DanielHeEGG/Nixie-Controller/README.md

# Nixie-Controller
Yet another nixie clock controller.

See [Hackaday Page](https://hackaday.io/project/180811-open-nixie-controller) for more details.

This project is archived, development is continuing in [v2](https://github.com/DanielHeEGG/Nixie-Controller-v2).
