DanielHeEGG/Nixie-Controller/Design/PowerSupply/PowerSupply.kicad_pcb

## KiCad design Design/PowerSupply/PowerSupply.kicad_pcb (2020-09-08)

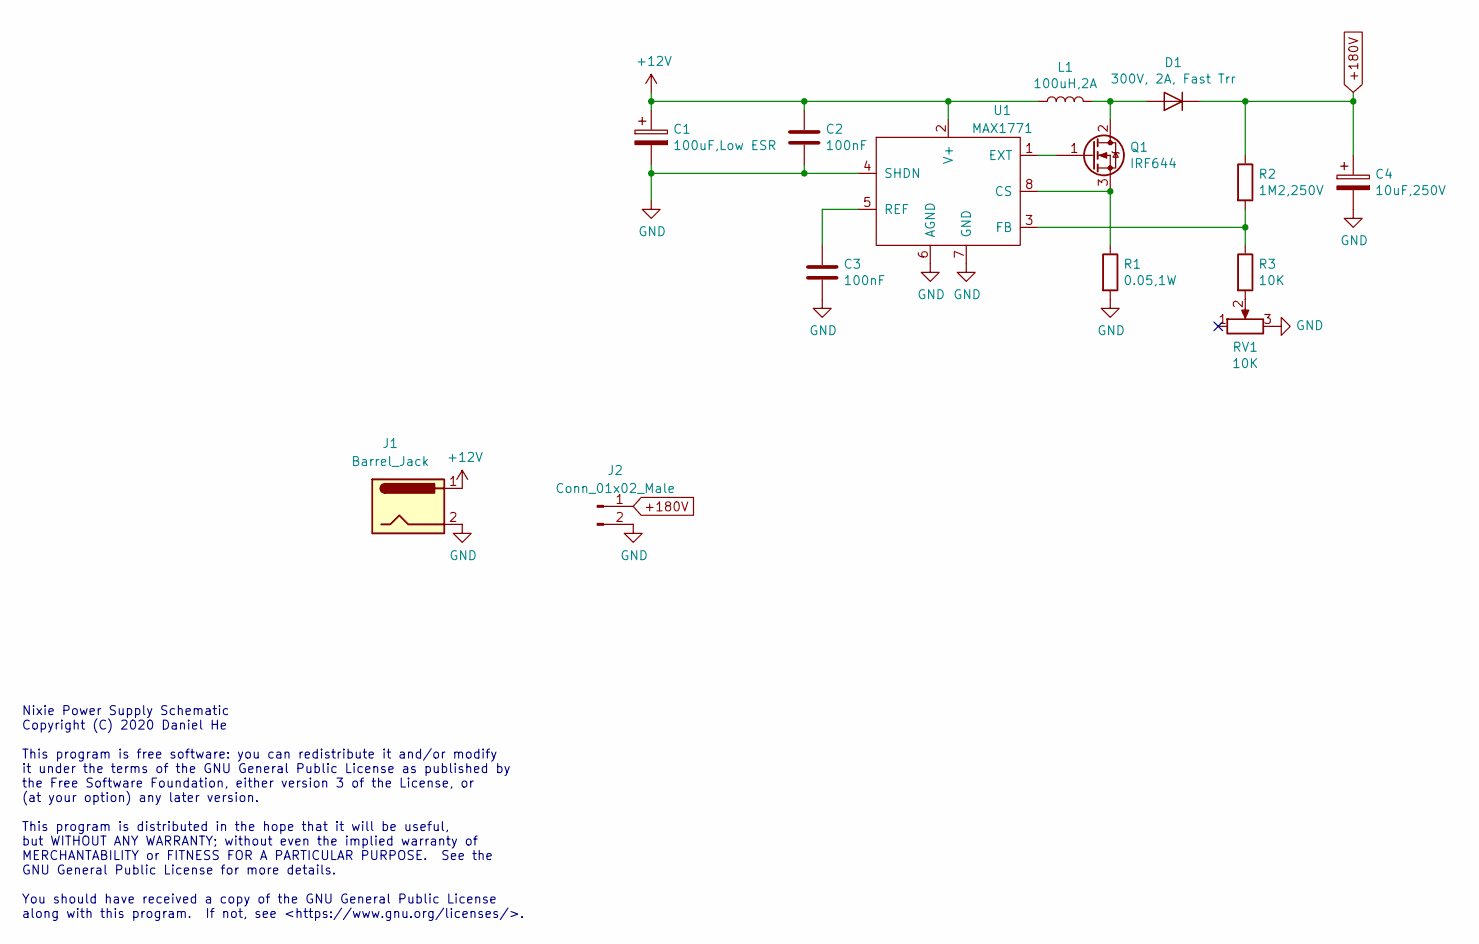
[picture p1: schematic PowerSupply.sch]

Parts:
C1: 100uF,Low ESR; CP_EIA-7343-31_Kemet-D; Digikey # 478-TPSD107M020R0150DKR-ND
C2, C3: 100nF; C_0805_2012Metric; Digikey # 1276-1007-6-ND
C4: 10uF,250V; CP_Elec_10x10; Digikey # PCE3432DKR-ND
D1: 300V, 2A, Fast Trr; D_SMB; Digikey # ES2F-E3/52TGIDKR-ND
J1: Barrel_Jack; BarrelJack_Horizontal; Digikey # 2092-KLDX-0202-A-ND
J2: Conn_01x02_Male; PinHeader_1x02_P2.54mm_Vertical
L1: 100uH,2A; L_12x12mm_H4.5mm; Digikey # 513-1526-6-ND
Q1: IRF644; TO-263-2; Digikey # IRF644STRLPBFDKR-ND
R1: 0.05,1W; R_2512_6332Metric; Digikey # YAG2156DKR-ND
R2: 1M2,250V; R_1206_3216Metric; Digikey # 311-1.2MERDKR-ND
R3: 10K; R_0805_2012Metric; Digikey # 311-10KARDKR-ND
RV1: 10K; Potentiometer_Bourns_3339P_Vertical; Digikey # 3362P-502LF-ND
U1: MAX1771; SOIC-8_3.9x4.9mm_P1.27mm; Digikey # MAX1771CSA+DKR-ND

Connections:
+12V: C1.1, C2.1, J1.1, L1.1, U1.2 (V+)
+180V: C4.1, D1.1 (K), J2.1, R2.1
GND: C1.2, C2.2, C3.2, C4.2, J1.2, J2.2, R1.2, RV1.3, U1.4 (SHDN), U1.6 (AGND), U1.7 (GND)
unnamed: C3.1, U1.5 (REF)
unnamed: D1.2 (A), L1.2, Q1.2 (D)
unnamed: Q1.1 (G), U1.1 (EXT)
unnamed: Q1.3 (S), R1.1, U1.8 (CS)
unnamed: R2.2, R3.1, U1.3 (FB)
unnamed: R3.2, RV1.2

Notes on the sheet:
Nixie Power Supply Schematic Copyright (C) 2020 Daniel He This program is free software: you can redistribute it and/or modify it under the terms of the GNU General Public License as published by the Free Software Foundation, either version 3 of the License, or (at your option) any later version. T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

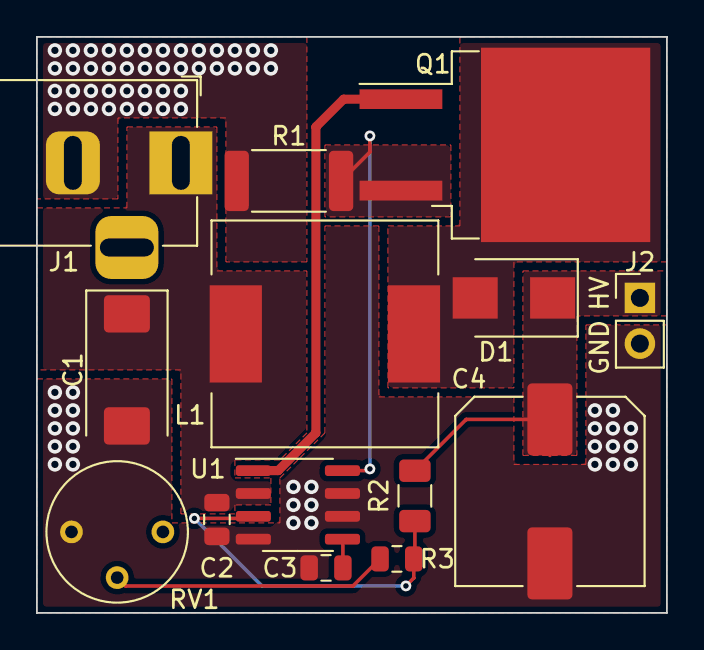
[picture p2: board PowerSupply.kicad_pcb from above]

Board: 2 copper layers, 35.0 x 32.0 mm, 15 parts (1 on the bottom side), 9 nets.

Other parts of the board:
CAUTION: Symbol_HighVoltage_Type2_CopperTop_VerySmall
