DanielHeEGG/Nixie-Controller/Design/Controller/NixieController.kicad_pcb

## KiCad design Design/Controller/NixieController.kicad_pcb (2020-09-08)

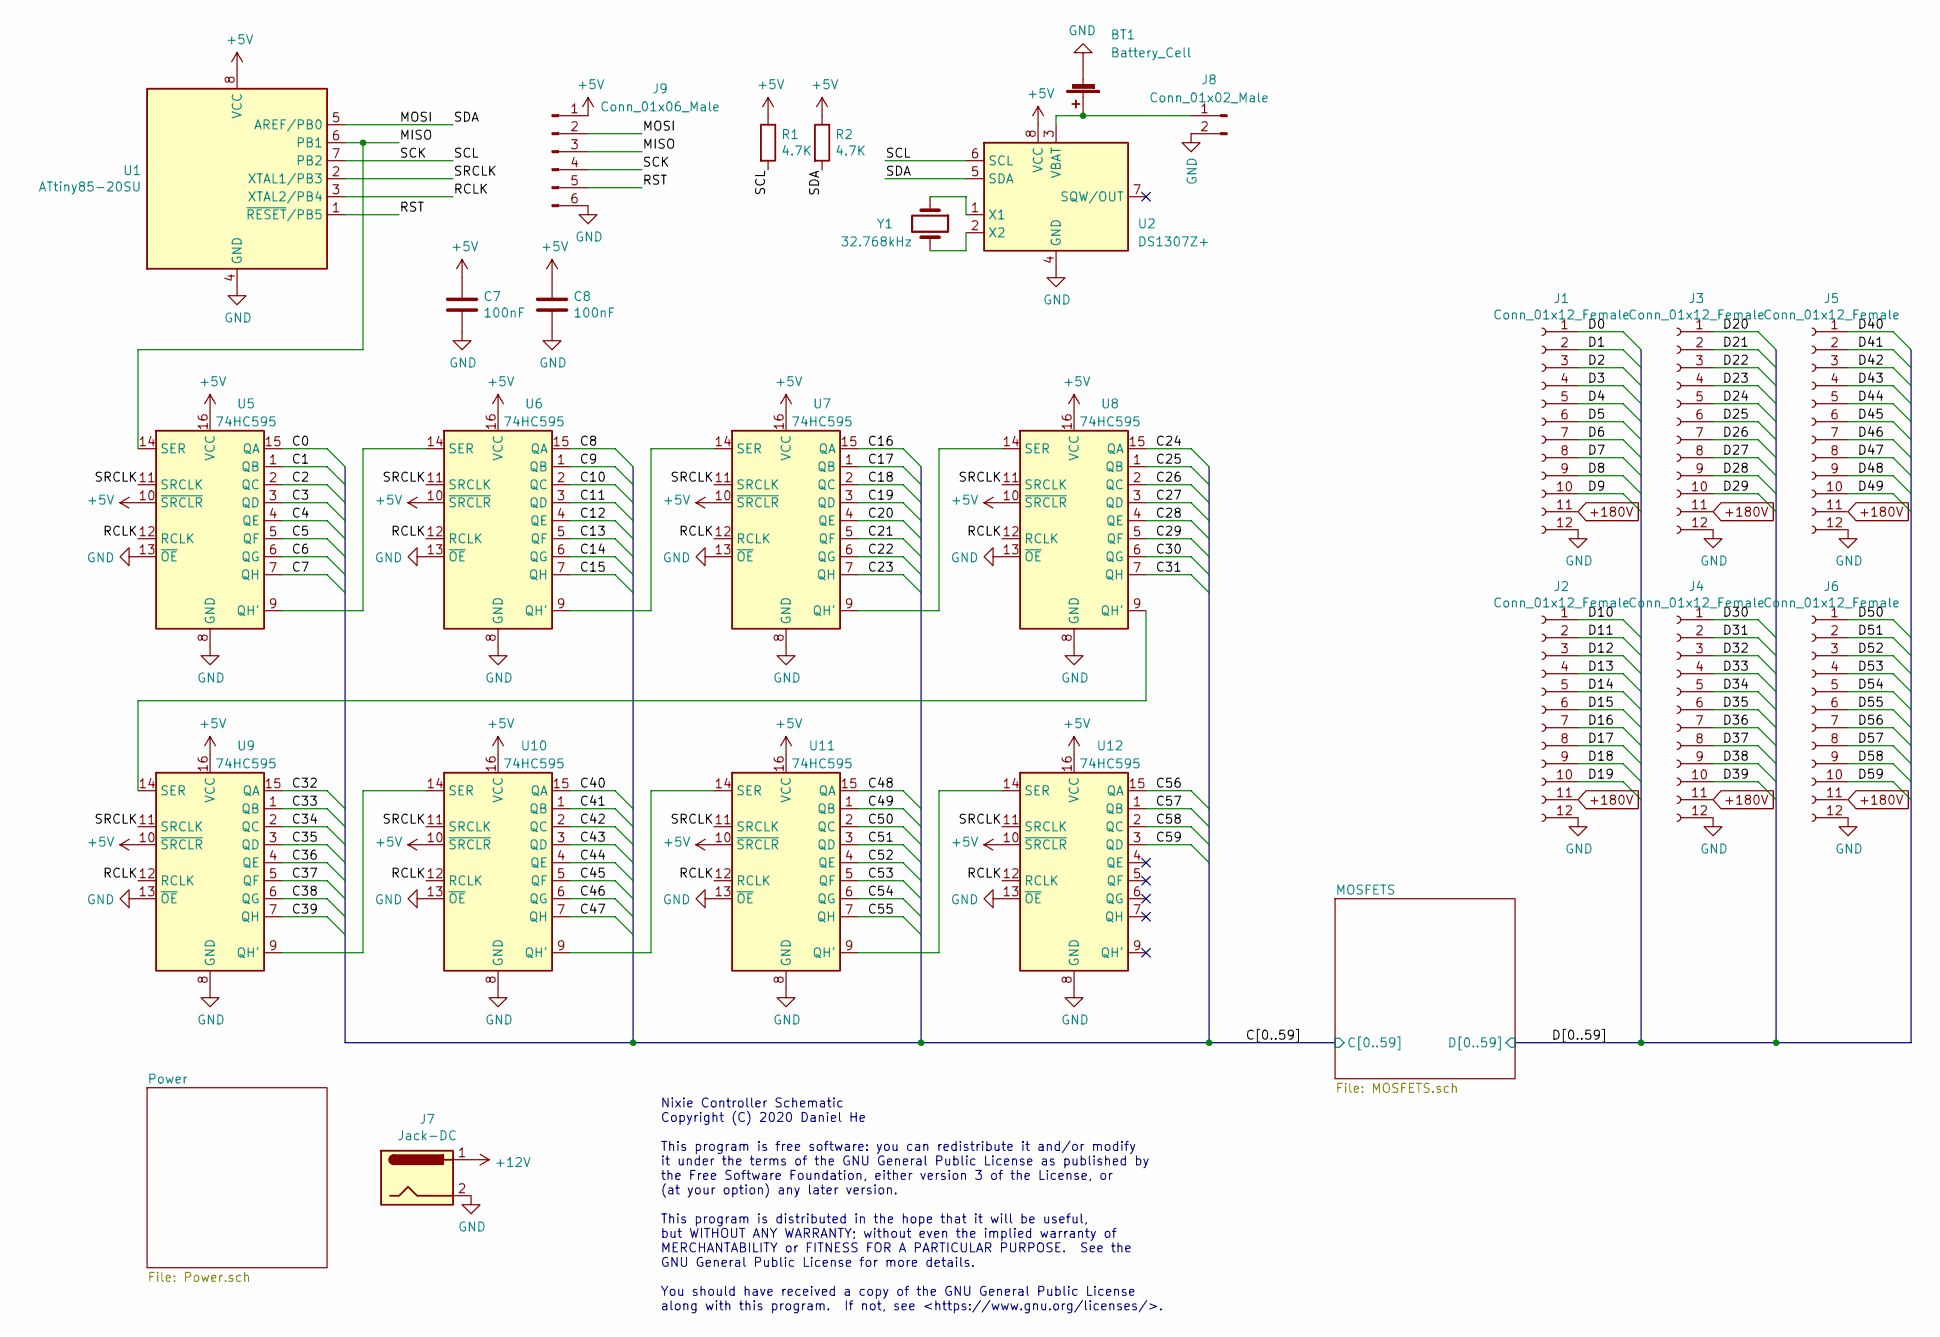
[picture p3: schematic NixieController.sch]

Parts:
BT1: Battery_Cell; Keystone_1056
C7, C8: 100nF; C_0805_2012Metric; Digikey # 1276-1007-6-ND
J1, J2, J3, J4, J5, J6: Conn_01x12_Female; PinSocket_1x12_P2.54mm_Vertical
J7: Jack-DC; BarrelJack_Horizontal; Digikey # 2092-KLDX-0202-A-ND
J8: Conn_01x02_Male; PinHeader_1x02_P2.54mm_Vertical
J9: Conn_01x06_Male; PinHeader_1x06_P2.54mm_Vertical
R1, R2: 4.7K; R_0805_2012Metric; Digikey # 311-4.7KARDKR-ND
U1: ATtiny85-20SU; SOIC-8_5.275x5.275mm_P1.27mm; Digikey # ATTINY85-20SURDKR-ND
U2: DS1307Z+; SOIC-8_3.9x4.9mm_P1.27mm; Digikey # DS1307Z+T&RDKR-ND
U5, U6, U7, U8, U9, U10, U11, U12: 74HC595; SOIC-16_3.9x9.9mm_P1.27mm; Digikey # 1727-2821-6-ND
Y1: 32.768kHz; Crystal_SMD_3215-2Pin_3.2x1.5mm; Digikey # SER4103DKR-ND

Connections:
+5V: C7.1, C8.1, J9.1, R1.1, R2.1, U1.8 (VCC), U2.8 (VCC), U5.10 (~SRCLR), U5.16 (VCC), U6.10 (~SRCLR), U6.16 (VCC), U7.10 (~SRCLR), U7.16 (VCC), U8.10 (~SRCLR), U8.16 (VCC), U9.10 (~SRCLR), U9.16 (VCC), U10.10 (~SRCLR), U10.16 (VCC), U11.10 (~SRCLR), U11.16 (VCC), U12.10 (~SRCLR), U12.16 (VCC); also elsewhere on the board
+12V: J7.1; also elsewhere on the board
+180V: J1.11, J2.11, J3.11, J4.11, J5.11, J6.11; also elsewhere on the board
/C0: U5.15 (QA); also elsewhere on the board
/C1: U5.1 (QB); also elsewhere on the board
/C2: U5.2 (QC); also elsewhere on the board
/C3: U5.3 (QD); also elsewhere on the board
/C4: U5.4 (QE); also elsewhere on the board
/C5: U5.5 (QF); also elsewhere on the board
/C6: U5.6 (QG); also elsewhere on the board
/C7: U5.7 (QH); also elsewhere on the board
/C8: U6.15 (QA); also elsewhere on the board
/C9: U6.1 (QB); also elsewhere on the board
/C10: U6.2 (QC); also elsewhere on the board
/C11: U6.3 (QD); also elsewhere on the board
/C12: U6.4 (QE); also elsewhere on the board
/C13: U6.5 (QF); also elsewhere on the board
/C14: U6.6 (QG); also elsewhere on the board
/C15: U6.7 (QH); also elsewhere on the board
/C16: U7.15 (QA); also elsewhere on the board
/C17: U7.1 (QB); also elsewhere on the board
/C18: U7.2 (QC); also elsewhere on the board
/C19: U7.3 (QD); also elsewhere on the board
/C20: U7.4 (QE); also elsewhere on the board
/C21: U7.5 (QF); also elsewhere on the board
/C22: U7.6 (QG); also elsewhere on the board
/C23: U7.7 (QH); also elsewhere on the board
/C24: U8.15 (QA); also elsewhere on the board
/C25: U8.1 (QB); also elsewhere on the board
/C26: U8.2 (QC); also elsewhere on the board
/C27: U8.3 (QD); also elsewhere on the board
/C28: U8.4 (QE); also elsewhere on the board
/C29: U8.5 (QF); also elsewhere on the board
/C30: U8.6 (QG); also elsewhere on the board
/C31: U8.7 (QH); also elsewhere on the board
/C32: U9.15 (QA); also elsewhere on the board
/C33: U9.1 (QB); also elsewhere on the board
/C34: U9.2 (QC); also elsewhere on the board
/C35: U9.3 (QD); also elsewhere on the board
/C36: U9.4 (QE); also elsewhere on the board
/C37: U9.5 (QF); also elsewhere on the board
/C38: U9.6 (QG); also elsewhere on the board
/C39: U9.7 (QH); also elsewhere on the board
/C40: U10.15 (QA); also elsewhere on the board
/C41: U10.1 (QB); also elsewhere on the board
/C42: U10.2 (QC); also elsewhere on the board
/C43: U10.3 (QD); also elsewhere on the board
/C44: U10.4 (QE); also elsewhere on the board
/C45: U10.5 (QF); also elsewhere on the board
/C46: U10.6 (QG); also elsewhere on the board
/C47: U10.7 (QH); also elsewhere on the board
/C48: U11.15 (QA); also elsewhere on the board
/C49: U11.1 (QB); also elsewhere on the board
/C50: U11.2 (QC); also elsewhere on the board
/C51: U11.3 (QD); also elsewhere on the board
/C52: U11.4 (QE); also elsewhere on the board
/C53: U11.5 (QF); also elsewhere on the board
/C54: U11.6 (QG); also elsewhere on the board
/C55: U11.7 (QH); also elsewhere on the board
/C56: U12.15 (QA); also elsewhere on the board
/C57: U12.1 (QB); also elsewhere on the board
/C58: U12.2 (QC); also elsewhere on the board
/C59: U12.3 (QD); also elsewhere on the board
/D0: J1.1; also elsewhere on the board
/D1: J1.2; also elsewhere on the board
/D2: J1.3; also elsewhere on the board
/D3: J1.4; also elsewhere on the board
/D4: J1.5; also elsewhere on the board
/D5: J1.6; also elsewhere on the board
/D6: J1.7; also elsewhere on the board
/D7: J1.8; also elsewhere on the board
/D8: J1.9; also elsewhere on the board
/D9: J1.10; also elsewhere on the board
/D10: J2.1; also elsewhere on the board
/D11: J2.2; also elsewhere on the board
/D12: J2.3; also elsewhere on the board
/D13: J2.4; also elsewhere on the board
/D14: J2.5; also elsewhere on the board
/D15: J2.6; also elsewhere on the board
/D16: J2.7; also elsewhere on the board
/D17: J2.8; also elsewhere on the board
/D18: J2.9; also elsewhere on the board
/D19: J2.10; also elsewhere on the board
/D20: J3.1; also elsewhere on the board
/D21: J3.2; also elsewhere on the board
/D22: J3.3; also elsewhere on the board
/D23: J3.4; also elsewhere on the board
/D24: J3.5; also elsewhere on the board
/D25: J3.6; also elsewhere on the board
/D26: J3.7; also elsewhere on the board
/D27: J3.8; also elsewhere on the board
/D28: J3.9; also elsewhere on the board
/D29: J3.10; also elsewhere on the board
/D30: J4.1; also elsewhere on the board
/D31: J4.2; also elsewhere on the board
/D32: J4.3; also elsewhere on the board
/D33: J4.4; also elsewhere on the board
/D34: J4.5; also elsewhere on the board
/D35: J4.6; also elsewhere on the board
/D36: J4.7; also elsewhere on the board
/D37: J4.8; also elsewhere on the board
/D38: J4.9; also elsewhere on the board
/D39: J4.10; also elsewhere on the board
/D40: J5.1; also elsewhere on the board
/D41: J5.2; also elsewhere on the board
/D42: J5.3; also elsewhere on the board
/D43: J5.4; also elsewhere on the board
/D44: J5.5; also elsewhere on the board
/D45: J5.6; also elsewhere on the board
/D46: J5.7; also elsewhere on the board
/D47: J5.8; also elsewhere on the board
/D48: J5.9; also elsewhere on the board
/D49: J5.10; also elsewhere on the board
/D50: J6.1; also elsewhere on the board
/D51: J6.2; also elsewhere on the board
/D52: J6.3; also elsewhere on the board
/D53: J6.4; also elsewhere on the board
/D54: J6.5; also elsewhere on the board
/D55: J6.6; also elsewhere on the board
/D56: J6.7; also elsewhere on the board
/D57: J6.8; also elsewhere on the board
/D58: J6.9; also elsewhere on the board
/D59: J6.10; also elsewhere on the board
/MISO: J9.3, U1.6 (PB1), U5.14 (SER)
/MOSI: J9.2, R2.2, U1.5 (AREF/PB0), U2.5 (SDA)
/RCLK: U1.3 (XTAL2/PB4), U5.12 (RCLK), U6.12 (RCLK), U7.12 (RCLK), U8.12 (RCLK), U9.12 (RCLK), U10.12 (RCLK), U11.12 (RCLK), U12.12 (RCLK)
/RST: J9.5, U1.1 (~RESET~/PB5)
/SCK: J9.4, R1.2, U1.7 (PB2), U2.6 (SCL)
/SRCLK: U1.2 (XTAL1/PB3), U5.11 (SRCLK), U6.11 (SRCLK), U7.11 (SRCLK), U8.11 (SRCLK), U9.11 (SRCLK), U10.11 (SRCLK), U11.11 (SRCLK), U12.11 (SRCLK)
GND: BT1.2 (-), C7.2, C8.2, J1.12, J2.12, J3.12, J4.12, J5.12, J6.12, J7.2, J8.2, J9.6, U1.4 (GND), U2.4 (GND), U5.8 (GND), U5.13 (~OE), U6.8 (GND), U6.13 (~OE), U7.8 (GND), U7.13 (~OE), U8.8 (GND), U8.13 (~OE), U9.8 (GND), U9.13 (~OE), U10.8 (GND), U10.13 (~OE), U11.8 (GND), U11.13 (~OE), U12.8 (GND), U12.13 (~OE); also elsewhere on the board
unnamed: BT1.1 (+), J8.1, U2.3 (VBAT)
unnamed: U2.1 (X1), Y1.1
unnamed: U2.2 (X2), Y1.2
unnamed: U5.9 (QH'), U6.14 (SER)
unnamed: U6.9 (QH'), U7.14 (SER)
unnamed: U7.9 (QH'), U8.14 (SER)
unnamed: U8.9 (QH'), U9.14 (SER)
unnamed: U10.9 (QH'), U11.14 (SER)
unnamed: U9.9 (QH'), U10.14 (SER)
unnamed: U11.9 (QH'), U12.14 (SER)

Notes on the sheet:
Nixie Controller Schematic Copyright (C) 2020 Daniel He This program is free software: you can redistribute it and/or modify it under the terms of the GNU General Public License as published by the Free Software Foundation, either version 3 of the License, or (at your option) any later version. Thi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

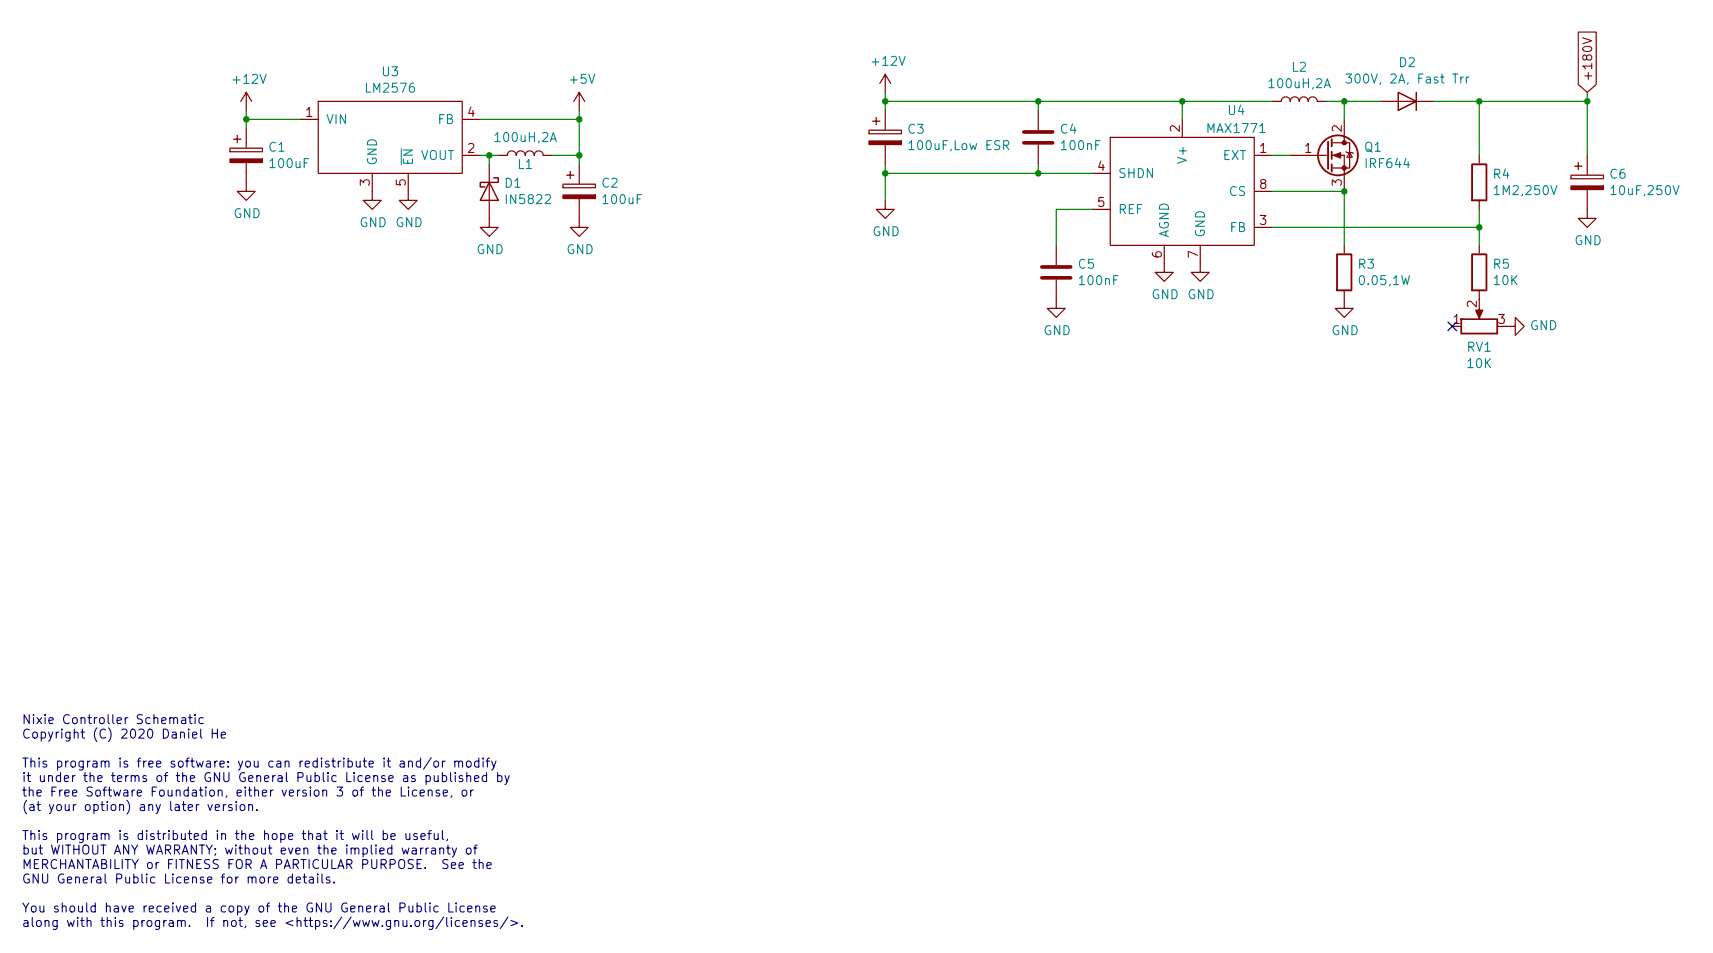
[picture p4: schematic Power.sch]

Parts:
C1, C2: 100uF; CP_Elec_6.3x7.7; Digikey # PCE3898DKR-ND
C3: 100uF,Low ESR; CP_EIA-7343-31_Kemet-D; Digikey # 478-TPSD107M020R0150DKR-ND
C4, C5: 100nF; C_0805_2012Metric; Digikey # 1276-1007-6-ND
C6: 10uF,250V; CP_Elec_10x10; Digikey # PCE3432DKR-ND
D1: IN5822; D_DO-201AD_P12.70mm_Horizontal; Digikey # 1N5822-E3/54GITR-ND
D2: 300V, 2A, Fast Trr; D_SMB; Digikey # ES2F-E3/52TGIDKR-ND
L1, L2: 100uH,2A; L_12x12mm_H4.5mm; Digikey # 513-1526-6-ND
Q1: IRF644; TO-263-2; Digikey # IRF644STRLPBFDKR-ND
R3: 0.05,1W; R_2512_6332Metric; Digikey # YAG2156DKR-ND
R4: 1M2,250V; R_1206_3216Metric; Digikey # 311-1.2MERDKR-ND
R5: 10K; R_0805_2012Metric; Digikey # 311-10KARDKR-ND
RV1: 10K; Potentiometer_Bourns_3339P_Vertical; Digikey # 3362P-502LF-ND
U3: LM2576; TO-263-5_TabPin3; Digikey # LM2576SX-5.0/NOPBDKR-ND
U4: MAX1771; SOIC-8_3.9x4.9mm_P1.27mm; Digikey # MAX1771CSA+DKR-ND

Connections:
+5V: C2.1, L1.2, U3.4 (FB); also elsewhere on the board
+12V: C1.1, C3.1, C4.1, L2.1, U3.1 (VIN), U4.2 (V+); also elsewhere on the board
+180V: C6.1, D2.1 (K), R4.1; also elsewhere on the board
GND: C1.2, C2.2, C3.2, C4.2, C5.2, C6.2, D1.2 (A), R3.2, RV1.3, U3.3 (GND), U3.5 (~EN), U4.4 (SHDN), U4.6 (AGND), U4.7 (GND); also elsewhere on the board
unnamed: C5.1, U4.5 (REF)
unnamed: D1.1 (K), L1.1, U3.2 (VOUT)
unnamed: D2.2 (A), L2.2, Q1.2 (D)
unnamed: Q1.1 (G), U4.1 (EXT)
unnamed: Q1.3 (S), R3.1, U4.8 (CS)
unnamed: R4.2, R5.1, U4.3 (FB)
unnamed: R5.2, RV1.2

Notes on the sheet:
Nixie Controller Schematic Copyright (C) 2020 Daniel He This program is free software: you can redistribute it and/or modify it under the terms of the GNU General Public License as published by the Free Software Foundation, either version 3 of the License, or (at your option) any later version. Thi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

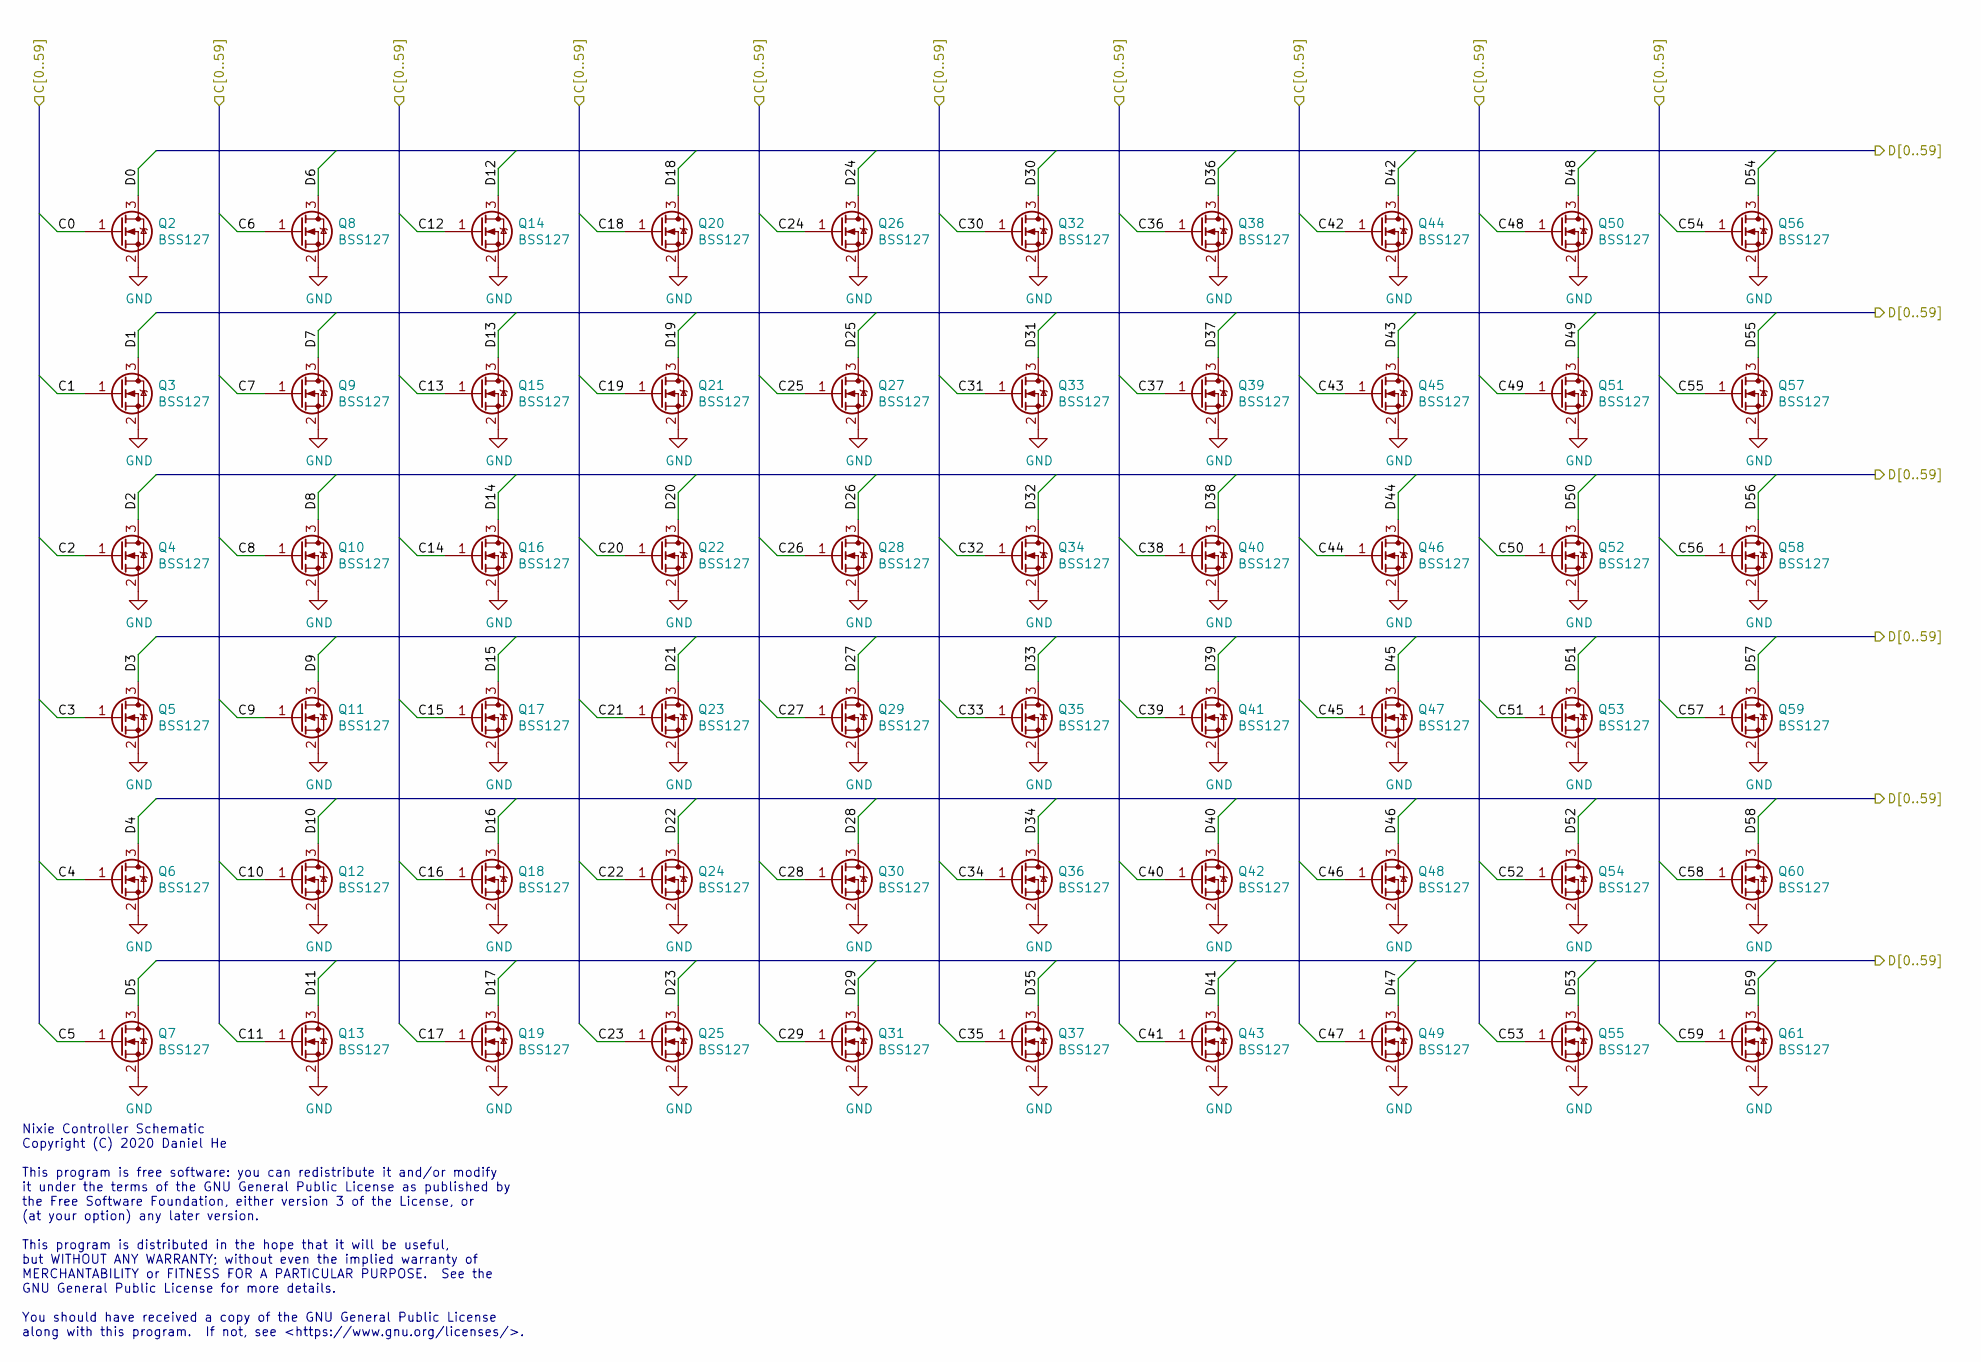
[picture p5: schematic MOSFETS.sch]

Parts:
Q2, Q3, Q4, Q5, Q6, Q7, Q8, Q9, Q10, Q11, Q12, Q13, Q14, Q15, Q16, Q17, Q18, Q19, Q20, Q21, Q22, Q23, Q24, Q25, Q26, Q27, Q28, Q29, Q30, Q31, Q32, Q33, Q34, Q35, Q36, Q37, Q38, Q39, Q40, Q41, Q42, Q43, Q44, Q45, Q46, Q47, Q48, Q49, Q50, Q51, Q52, Q53, Q54, Q55, Q56, Q57, Q58, Q59, Q60, Q61: BSS127; SOT-23; Digikey # BSS127S-7DIDKR-ND

Connections:
/C0: Q2.1 (G); also elsewhere on the board
/C1: Q3.1 (G); also elsewhere on the board
/C2: Q4.1 (G); also elsewhere on the board
/C3: Q5.1 (G); also elsewhere on the board
/C4: Q6.1 (G); also elsewhere on the board
/C5: Q7.1 (G); also elsewhere on the board
/C6: Q8.1 (G); also elsewhere on the board
/C7: Q9.1 (G); also elsewhere on the board
/C8: Q10.1 (G); also elsewhere on the board
/C9: Q11.1 (G); also elsewhere on the board
/C10: Q12.1 (G); also elsewhere on the board
/C11: Q13.1 (G); also elsewhere on the board
/C12: Q14.1 (G); also elsewhere on the board
/C13: Q15.1 (G); also elsewhere on the board
/C14: Q16.1 (G); also elsewhere on the board
/C15: Q17.1 (G); also elsewhere on the board
/C16: Q18.1 (G); also elsewhere on the board
/C17: Q19.1 (G); also elsewhere on the board
/C18: Q20.1 (G); also elsewhere on the board
/C19: Q21.1 (G); also elsewhere on the board
/C20: Q22.1 (G); also elsewhere on the board
/C21: Q23.1 (G); also elsewhere on the board
/C22: Q24.1 (G); also elsewhere on the board
/C23: Q25.1 (G); also elsewhere on the board
/C24: Q26.1 (G); also elsewhere on the board
/C25: Q27.1 (G); also elsewhere on the board
/C26: Q28.1 (G); also elsewhere on the board
/C27: Q29.1 (G); also elsewhere on the board
/C28: Q30.1 (G); also elsewhere on the board
/C29: Q31.1 (G); also elsewhere on the board
/C30: Q32.1 (G); also elsewhere on the board
/C31: Q33.1 (G); also elsewhere on the board
/C32: Q34.1 (G); also elsewhere on the board
/C33: Q35.1 (G); also elsewhere on the board
/C34: Q36.1 (G); also elsewhere on the board
/C35: Q37.1 (G); also elsewhere on the board
/C36: Q38.1 (G); also elsewhere on the board
/C37: Q39.1 (G); also elsewhere on the board
/C38: Q40.1 (G); also elsewhere on the board
/C39: Q41.1 (G); also elsewhere on the board
/C40: Q42.1 (G); also elsewhere on the board
/C41: Q43.1 (G); also elsewhere on the board
/C42: Q44.1 (G); also elsewhere on the board
/C43: Q45.1 (G); also elsewhere on the board
/C44: Q46.1 (G); also elsewhere on the board
/C45: Q47.1 (G); also elsewhere on the board
/C46: Q48.1 (G); also elsewhere on the board
/C47: Q49.1 (G); also elsewhere on the board
/C48: Q50.1 (G); also elsewhere on the board
/C49: Q51.1 (G); also elsewhere on the board
/C50: Q52.1 (G); also elsewhere on the board
/C51: Q53.1 (G); also elsewhere on the board
/C52: Q54.1 (G); also elsewhere on the board
/C53: Q55.1 (G); also elsewhere on the board
/C54: Q56.1 (G); also elsewhere on the board
/C55: Q57.1 (G); also elsewhere on the board
/C56: Q58.1 (G); also elsewhere on the board
/C57: Q59.1 (G); also elsewhere on the board
/C58: Q60.1 (G); also elsewhere on the board
/C59: Q61.1 (G); also elsewhere on the board
/D0: Q2.3 (D); also elsewhere on the board
/D1: Q3.3 (D); also elsewhere on the board
/D2: Q4.3 (D); also elsewhere on the board
/D3: Q5.3 (D); also elsewhere on the board
/D4: Q6.3 (D); also elsewhere on the board
/D5: Q7.3 (D); also elsewhere on the board
/D6: Q8.3 (D); also elsewhere on the board
/D7: Q9.3 (D); also elsewhere on the board
/D8: Q10.3 (D); also elsewhere on the board
/D9: Q11.3 (D); also elsewhere on the board
/D10: Q12.3 (D); also elsewhere on the board
/D11: Q13.3 (D); also elsewhere on the board
/D12: Q14.3 (D); also elsewhere on the board
/D13: Q15.3 (D); also elsewhere on the board
/D14: Q16.3 (D); also elsewhere on the board
/D15: Q17.3 (D); also elsewhere on the board
/D16: Q18.3 (D); also elsewhere on the board
/D17: Q19.3 (D); also elsewhere on the board
/D18: Q20.3 (D); also elsewhere on the board
/D19: Q21.3 (D); also elsewhere on the board
/D20: Q22.3 (D); also elsewhere on the board
/D21: Q23.3 (D); also elsewhere on the board
/D22: Q24.3 (D); also elsewhere on the board
/D23: Q25.3 (D); also elsewhere on the board
/D24: Q26.3 (D); also elsewhere on the board
/D25: Q27.3 (D); also elsewhere on the board
/D26: Q28.3 (D); also elsewhere on the board
/D27: Q29.3 (D); also elsewhere on the board
/D28: Q30.3 (D); also elsewhere on the board
/D29: Q31.3 (D); also elsewhere on the board
/D30: Q32.3 (D); also elsewhere on the board
/D31: Q33.3 (D); also elsewhere on the board
/D32: Q34.3 (D); also elsewhere on the board
/D33: Q35.3 (D); also elsewhere on the board
/D34: Q36.3 (D); also elsewhere on the board
/D35: Q37.3 (D); also elsewhere on the board
/D36: Q38.3 (D); also elsewhere on the board
/D37: Q39.3 (D); also elsewhere on the board
/D38: Q40.3 (D); also elsewhere on the board
/D39: Q41.3 (D); also elsewhere on the board
/D40: Q42.3 (D); also elsewhere on the board
/D41: Q43.3 (D); also elsewhere on the board
/D42: Q44.3 (D); also elsewhere on the board
/D43: Q45.3 (D); also elsewhere on the board
/D44: Q46.3 (D); also elsewhere on the board
/D45: Q47.3 (D); also elsewhere on the board
/D46: Q48.3 (D); also elsewhere on the board
/D47: Q49.3 (D); also elsewhere on the board
/D48: Q50.3 (D); also elsewhere on the board
/D49: Q51.3 (D); also elsewhere on the board
/D50: Q52.3 (D); also elsewhere on the board
/D51: Q53.3 (D); also elsewhere on the board
/D52: Q54.3 (D); also elsewhere on the board
/D53: Q55.3 (D); also elsewhere on the board
/D54: Q56.3 (D); also elsewhere on the board
/D55: Q57.3 (D); also elsewhere on the board
/D56: Q58.3 (D); also elsewhere on the board
/D57: Q59.3 (D); also elsewhere on the board
/D58: Q60.3 (D); also elsewhere on the board
/D59: Q61.3 (D); also elsewhere on the board
GND: Q2.2 (S), Q3.2 (S), Q4.2 (S), Q5.2 (S), Q6.2 (S), Q7.2 (S), Q8.2 (S), Q9.2 (S), Q10.2 (S), Q11.2 (S), Q12.2 (S), Q13.2 (S), Q14.2 (S), Q15.2 (S), Q16.2 (S), Q17.2 (S), Q18.2 (S), Q19.2 (S), Q20.2 (S), Q21.2 (S), Q22.2 (S), Q23.2 (S), Q24.2 (S), Q25.2 (S), Q26.2 (S), Q27.2 (S), Q28.2 (S), Q29.2 (S), Q30.2 (S), Q31.2 (S), Q32.2 (S), Q33.2 (S), Q34.2 (S), Q35.2 (S), Q36.2 (S), Q37.2 (S), Q38.2 (S), Q39.2 (S), Q40.2 (S), Q41.2 (S), Q42.2 (S), Q43.2 (S), Q44.2 (S), Q45.2 (S), Q46.2 (S), Q47.2 (S), Q48.2 (S), Q49.2 (S), Q50.2 (S), Q51.2 (S), Q52.2 (S), Q53.2 (S), Q54.2 (S), Q55.2 (S), Q56.2 (S), Q57.2 (S), Q58.2 (S), Q59.2 (S), Q60.2 (S), Q61.2 (S); also elsewhere on the board

Notes on the sheet:
Nixie Controller Schematic Copyright (C) 2020 Daniel He This program is free software: you can redistribute it and/or modify it under the terms of the GNU General Public License as published by the Free Software Foundation, either version 3 of the License, or (at your option) any later version. Thi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

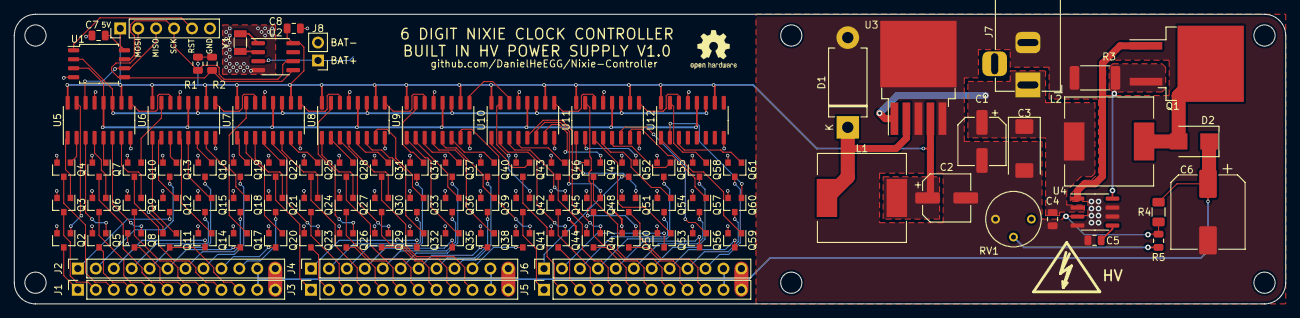
[picture p6: board NixieController.kicad_pcb from above]

Board: 2 copper layers, 180.0 x 41.0 mm, 102 parts (1 on the bottom side), 147 nets.
