DanielHeEGG/Nixie-Controller/Design/Sockets/IN-8/IN-8.kicad_pcb

## KiCad design Design/Sockets/IN-8/IN-8.kicad_pcb (2020-09-08)

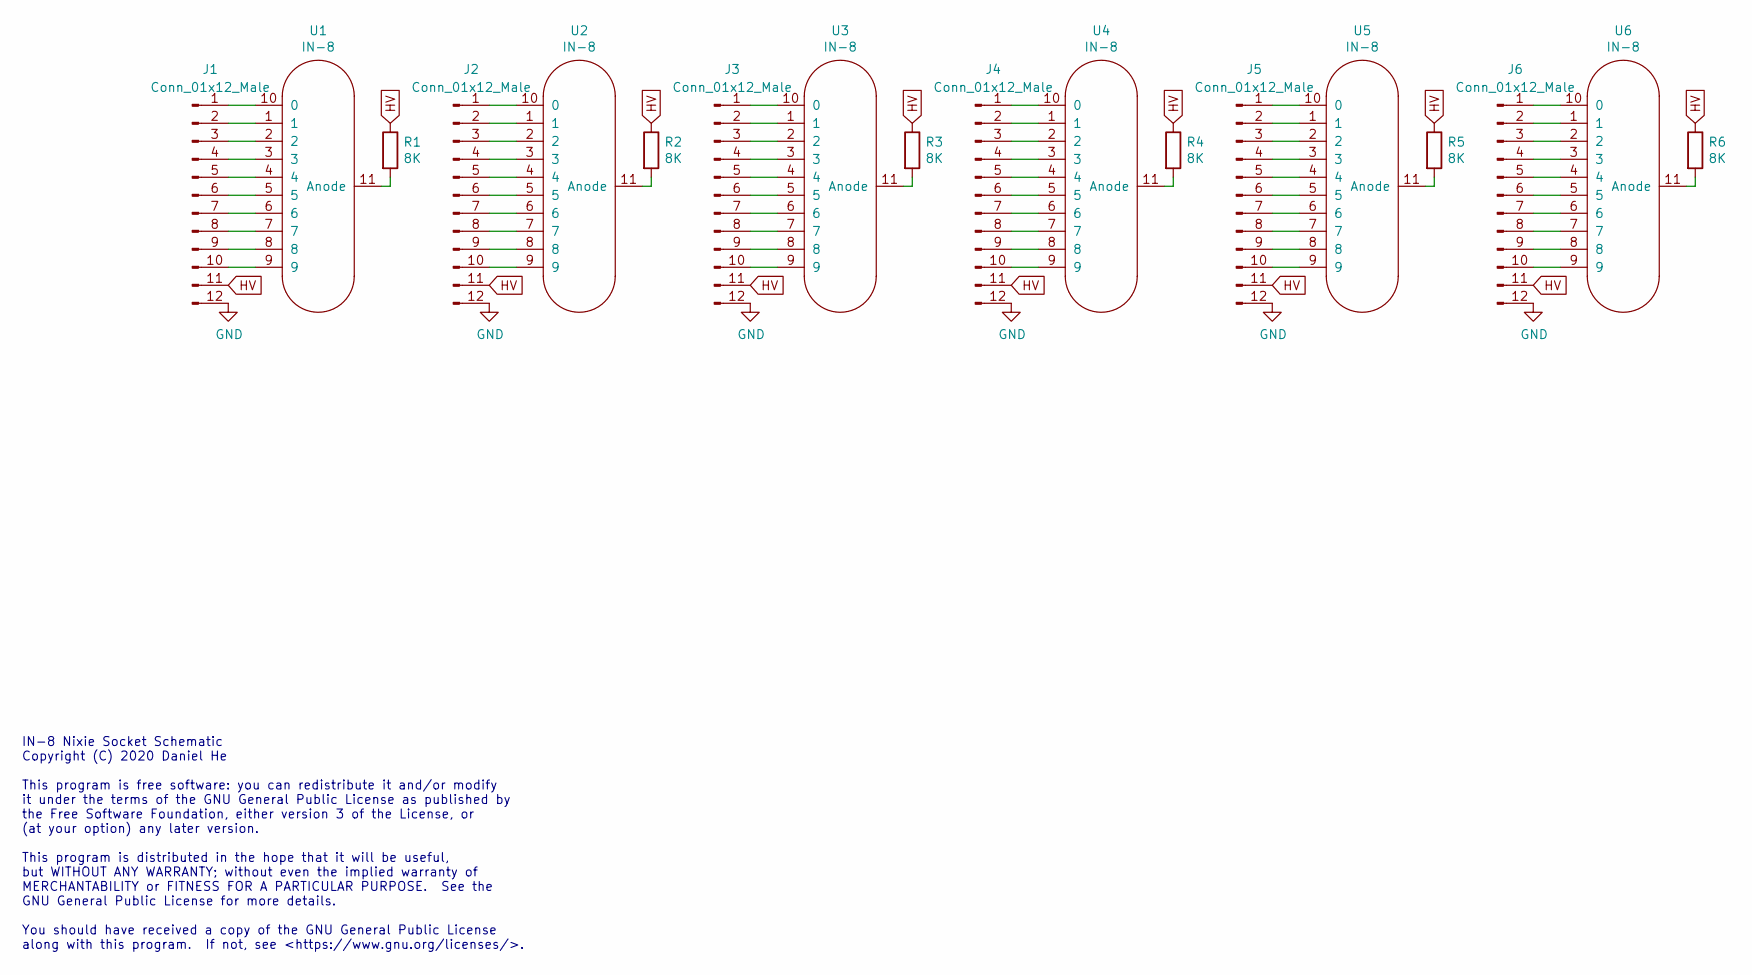
[picture p7: schematic IN-8.sch]

Parts:
J1, J2, J3, J4, J5, J6: Conn_01x12_Male; PinHeader_1x12_P2.54mm_Vertical
R1, R2, R3, R4, R5, R6: 8K; R_0805_2012Metric
U1, U2, U3, U4, U5, U6: IN-8

Connections:
GND: J1.12, J2.12, J3.12, J4.12, J5.12, J6.12
HV: J1.11, J2.11, J3.11, J4.11, J5.11, J6.11, R1.1, R2.1, R3.1, R4.1, R5.1, R6.1
unnamed: J1.1, U1.10 (0)
unnamed: J1.2, U1.1
unnamed: J1.3, U1.2
unnamed: J1.4, U1.3
unnamed: J1.5, U1.4
unnamed: J1.6, U1.5
unnamed: J1.7, U1.6
unnamed: J1.8, U1.7
unnamed: J1.9, U1.8
unnamed: J1.10, U1.9
unnamed: J2.1, U2.10 (0)
unnamed: J2.2, U2.1
unnamed: J2.3, U2.2
unnamed: J2.4, U2.3
unnamed: J2.5, U2.4
unnamed: J2.6, U2.5
unnamed: J2.7, U2.6
unnamed: J2.8, U2.7
unnamed: J2.9, U2.8
unnamed: J2.10, U2.9
unnamed: J3.1, U3.10 (0)
unnamed: J3.2, U3.1
unnamed: J3.3, U3.2
unnamed: J3.4, U3.3
unnamed: J3.5, U3.4
unnamed: J3.6, U3.5
unnamed: J3.7, U3.6
unnamed: J3.8, U3.7
unnamed: J3.9, U3.8
unnamed: J3.10, U3.9
unnamed: J4.1, U4.10 (0)
unnamed: J4.2, U4.1
unnamed: J4.3, U4.2
unnamed: J4.4, U4.3
unnamed: J4.5, U4.4
unnamed: J4.6, U4.5
unnamed: J4.7, U4.6
unnamed: J4.8, U4.7
unnamed: J4.9, U4.8
unnamed: J4.10, U4.9
unnamed: J5.1, U5.10 (0)
unnamed: J5.2, U5.1
unnamed: J5.3, U5.2
unnamed: J5.4, U5.3
unnamed: J5.5, U5.4
unnamed: J5.6, U5.5
unnamed: J5.7, U5.6
unnamed: J5.8, U5.7
unnamed: J5.9, U5.8
unnamed: J5.10, U5.9
unnamed: J6.1, U6.10 (0)
unnamed: J6.2, U6.1
unnamed: J6.3, U6.2
unnamed: J6.4, U6.3
unnamed: J6.5, U6.4
unnamed: J6.6, U6.5
unnamed: J6.7, U6.6
unnamed: J6.8, U6.7
unnamed: J6.9, U6.8
unnamed: J6.10, U6.9
unnamed: R1.2, U1.11 (Anode)
unnamed: R2.2, U2.11 (Anode)
unnamed: R3.2, U3.11 (Anode)
unnamed: R4.2, U4.11 (Anode)
unnamed: R5.2, U5.11 (Anode)
unnamed: R6.2, U6.11 (Anode)

Notes on the sheet:
IN-8 Nixie Socket Schematic Copyright (C) 2020 Daniel He This program is free software: you can redistribute it and/or modify it under the terms of the GNU General Public License as published by the Free Software Foundation, either version 3 of the License, or (at your option) any later version. Th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
