DanielHeEGG/Nixie-Controller/Design/Sockets/IN-8/IN-8.kicad_pcb

## KiCad design Design/Sockets/IN-8/IN-8.kicad_pcb (continued)

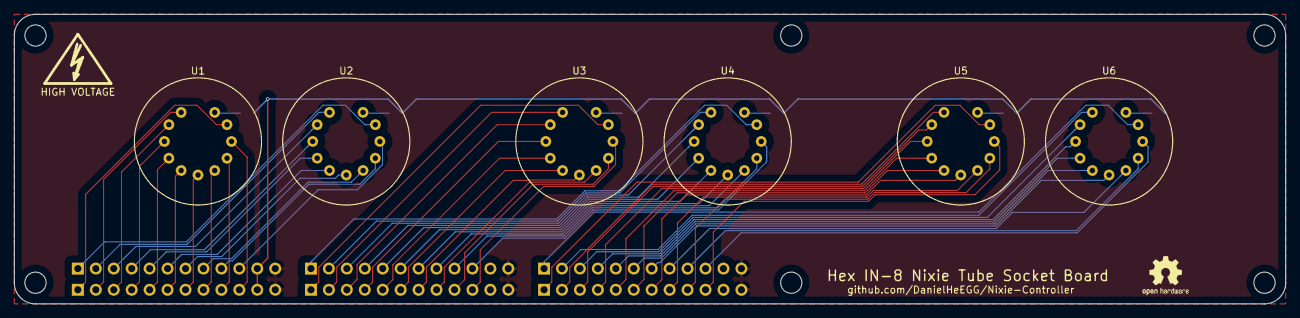
[picture p8: board IN-8.kicad_pcb from above]

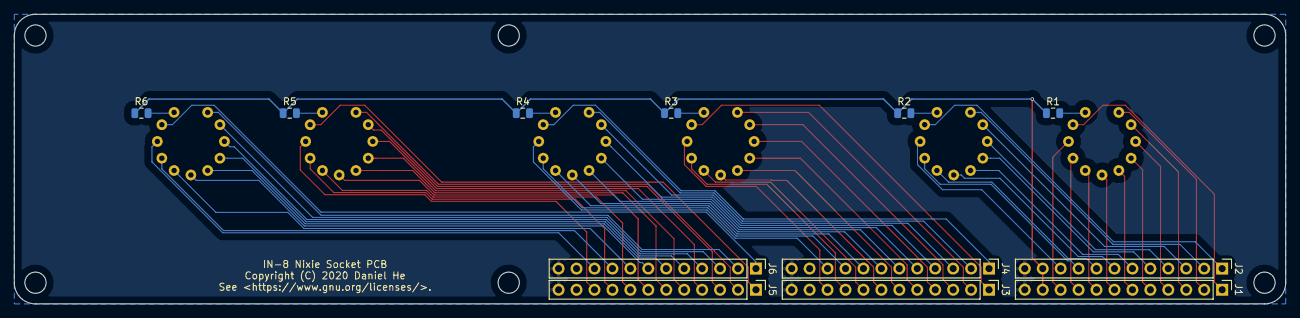
[picture p9: board IN-8.kicad_pcb from below]

Board: 2 copper layers, 180.0 x 41.0 mm, 18 parts (12 on the bottom side), 68 nets.
