DanielHeEGG/Nixie-Controller/Design/Sockets/IN-18/IN-18.kicad_pcb

## KiCad design Design/Sockets/IN-18/IN-18.kicad_pcb (2020-09-08)

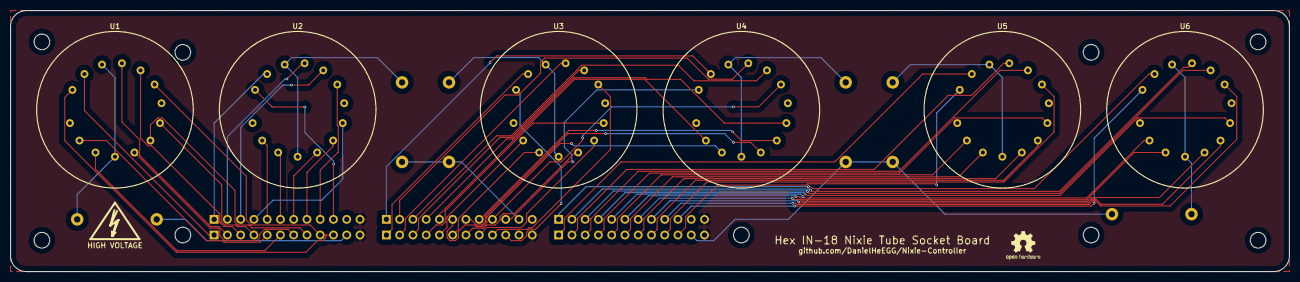
[picture p10: board IN-18.kicad_pcb from above]

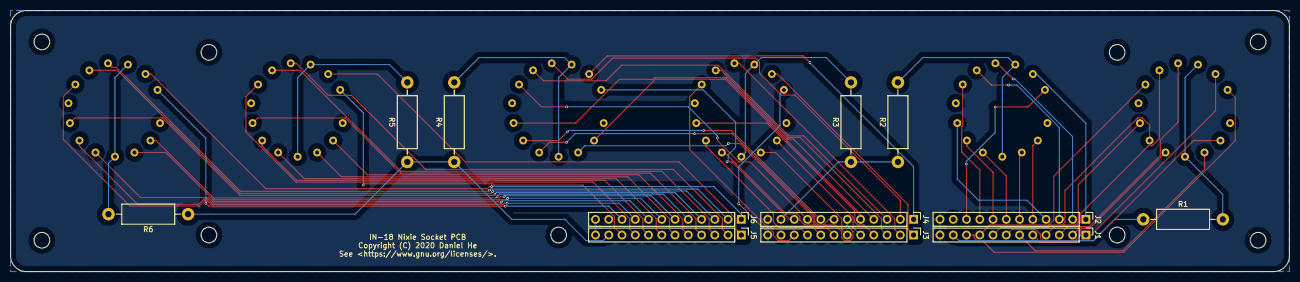
[picture p11: board IN-18.kicad_pcb from below]

Board: 2 copper layers, 245.0 x 50.0 mm, 18 parts (12 on the bottom side), 69 nets.

Parts:
J1, J2, J3, J4, J5, J6: Conn_01x12_Male; PinHeader_1x12_P2.54mm_Vertical
R1, R2, R3, R4, R5, R6: 3K; R_Axial_DIN0411_L9.9mm_D3.6mm_P15.24mm_Horizontal
U1, U2, U3, U4, U5, U6: IN-18

Connections:
Anode: R1.2, R2.2, R3.2, R4.2, R5.2, R6.2, U1.4, U1.12, U2.4, U2.12, U3.4, U3.12, U4.4, U4.12, U5.4, U5.12, U6.4, U6.12
GND: J1.12, J2.12, J3.12, J4.12, J5.12, J6.12
HV: J1.11, J2.11, J3.11, J4.11, J5.11, J6.11, R1.1, R2.1, R3.1, R4.1, R5.1, R6.1
unnamed: J1.1, U1.13
unnamed: J1.2, U1.11
unnamed: J1.3, U1.10
unnamed: J1.4, U1.7
unnamed: J1.5, U1.2
unnamed: J1.6, U1.3
unnamed: J1.7, U1.5
unnamed: J1.8, U1.6
unnamed: J1.9, U1.9
unnamed: J1.10, U1.14
unnamed: J2.1, U2.13
unnamed: J2.2, U2.11
unnamed: J2.3, U2.10
unnamed: J2.4, U2.7
unnamed: J2.5, U2.2
unnamed: J2.6, U2.3
unnamed: J2.7, U2.5
unnamed: J2.8, U2.6
unnamed: J2.9, U2.9
unnamed: J2.10, U2.14
unnamed: J3.1, U3.13
unnamed: J3.2, U3.11
unnamed: J3.3, U3.10
unnamed: J3.4, U3.7
unnamed: J3.5, U3.2
unnamed: J3.6, U3.3
unnamed: J3.7, U3.5
unnamed: J3.8, U3.6
unnamed: J3.9, U3.9
unnamed: J3.10, U3.14
unnamed: J4.1, U4.13
unnamed: J4.2, U4.11
unnamed: J4.3, U4.10
unnamed: J4.4, U4.7
unnamed: J4.5, U4.2
unnamed: J4.6, U4.3
unnamed: J4.7, U4.5
unnamed: J4.8, U4.6
unnamed: J4.9, U4.9
unnamed: J4.10, U4.14
unnamed: J5.1, U5.13
unnamed: J5.2, U5.11
unnamed: J5.3, U5.10
unnamed: J5.4, U5.7
unnamed: J5.5, U5.2
unnamed: J5.6, U5.3
unnamed: J5.7, U5.5
unnamed: J5.8, U5.6
unnamed: J5.9, U5.9
unnamed: J5.10, U5.14
unnamed: J6.1, U6.13
unnamed: J6.2, U6.11
unnamed: J6.3, U6.10
unnamed: J6.4, U6.7
unnamed: J6.5, U6.2
unnamed: J6.6, U6.3
unnamed: J6.7, U6.5
unnamed: J6.8, U6.6
unnamed: J6.9, U6.9
unnamed: J6.10, U6.14
unnamed: U1.1, U1.8
unnamed: U2.1, U2.8
unnamed: U3.1, U3.8
unnamed: U4.1, U4.8
unnamed: U5.1, U5.8
unnamed: U6.1, U6.8
