DanielHeEGG/Nixie-Controller/(commit log)

2020-04-17 Add HV power supply
    [NixieController-B_Cu.gbr, NixieController-B_Mask.gbr, NixieController-B_Paste.gbr, NixieController-B_SilkS.gbr, NixieController-Edge_Cuts.gbr, NixieController-F_Cu.gbr, NixieController-F_Mask.gbr, NixieController-F_Paste.gbr]
2020-04-20 Add potentiometer to allow variable output voltage
    [NixieController-B_Cu.gbr, NixieController-B_Mask.gbr, NixieController-B_Paste.gbr, NixieController-B_SilkS.gbr, NixieController-Edge_Cuts.gbr, NixieController-F_Cu.gbr, NixieController-F_Mask.gbr, NixieController-F_Paste.gbr]
2020-04-21 Completed entire board (not tested yet)
    [MOSFETS.sch, NixieController.kicad_pcb, NixieController.sch, Power.sch]
2020-05-01 Remove feed forward cap for output stabillity
    [NixieController-B_Cu.gbr, NixieController-B_Mask.gbr, NixieController-B_Paste.gbr, NixieController-B_SilkS.gbr, NixieController-Edge_Cuts.gbr, NixieController-F_Cu.gbr, NixieController-F_Mask.gbr, NixieController-F_Paste.gbr]
2020-05-01 Add ICSP for ucontroller, remove access to I2C
    [NixieController-B_Cu.gbr, NixieController-B_Mask.gbr, NixieController-B_Paste.gbr, NixieController-B_SilkS.gbr, NixieController-Edge_Cuts.gbr, NixieController-F_Cu.gbr, NixieController-F_Mask.gbr, NixieController-F_Paste.gbr]
2020-05-01 Change file structure
    [MOSFETS.sch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]
2020-05-01 Seperate power supply files into different folder
    [NixieController.kicad_pcb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]
2020-05-01 Add github link to controller, fix ground plane issues
    [NixieController-B_Cu.gbr, NixieController-B_Mask.gbr, NixieController-B_Paste.gbr, NixieController-B_SilkS.gbr, NixieController-Edge_Cuts.gbr, NixieController-F_Cu.gbr, NixieController-F_Mask.gbr, NixieController-F_Paste.gbr]
2020-05-01 Add IN-18 nixie socket board
    [IN-18-B_Cu.gbr, IN-18-B_Mask.gbr, IN-18-B_Paste.gbr, IN-18-B_SilkS.gbr, IN-18-Edge_Cuts.gbr, IN-18-F_Cu.gbr, IN-18-F_Mask.gbr, IN-18-F_Paste.gbr]
2020-05-01 Change pin header on controller from male to female
    [NixieController-B_Cu.gbr, NixieController-B_Mask.gbr, NixieController-B_Paste.gbr, NixieController-B_SilkS.gbr, NixieController-Edge_Cuts.gbr, NixieController-F_Cu.gbr, NixieController-F_Mask.gbr, NixieController-F_Paste.gbr]
2020-05-05 Add battery mount to controller
    [NixieController-B_Cu.gbr, NixieController-B_Mask.gbr, NixieController-B_Paste.gbr, NixieController-B_SilkS.gbr, NixieController-Edge_Cuts.gbr, NixieController-F_Cu.gbr, NixieController-F_Mask.gbr, NixieController-F_Paste.gbr]
2020-05-10 Add bypass caps for micro and RTC
    [NixieController-B_Cu.gbr, NixieController-B_Mask.gbr, NixieController-B_Paste.gbr, NixieController-B_SilkS.gbr, NixieController-Edge_Cuts.gbr, NixieController-F_Cu.gbr, NixieController-F_Mask.gbr, NixieController-F_Paste.gbr]
2020-07-08 Reorganize project file structure
    [IN-18-B_Cu.gbr, IN-18-B_Mask.gbr, IN-18-B_Paste.gbr, IN-18-B_SilkS.gbr, IN-18-Edge_Cuts.gbr, IN-18-F_Cu.gbr, IN-18-F_Mask.gbr, IN-18-F_Paste.gbr]
2020-07-17 Add part numbers to symbols in PowerSupply schematic for BOM
    [PowerSupply.sch]
2020-07-17 Add part numbers to symbols in NixieController schematic for BOM
    [MOSFETS.sch, NixieController.sch, Power.sch]
2020-07-18 Create IN-8 socket board schematic & fabrication files
    [IN-8-B_Cu.gbr, IN-8-B_Mask.gbr, IN-8-B_Paste.gbr, IN-8-B_SilkS.gbr, IN-8-Edge_Cuts.gbr, IN-8-F_Cu.gbr, IN-8-F_Mask.gbr, IN-8-F_Paste.gbr]
2020-07-18 Add front copper plane to IN-18 socket board, increase clearance, add high voltage warning symbol
    [IN-18-B_Cu.gbr, IN-18-B_Mask.gbr, IN-18-B_Paste.gbr, IN-18-B_SilkS.gbr, IN-18-Edge_Cuts.gbr, IN-18-F_Cu.gbr, IN-18-F_Mask.gbr, IN-18-F_Paste.gbr]
2020-07-29 Fix IN-8 socket board orientation issue
    [IN-8-B_Cu.gbr, IN-8-B_Mask.gbr, IN-8-B_Paste.gbr, IN-8-B_SilkS.gbr, IN-8-Edge_Cuts.gbr, IN-8-F_Cu.gbr, IN-8-F_Mask.gbr, IN-8-F_Paste.gbr]
2020-09-07 Remove BOM file which was accidentally included due to incorrect file type
2020-09-08 Add license notice to all human readable files
    [IN-18-B_Cu.gbr, IN-18-B_Mask.gbr, IN-18-B_Paste.gbr, IN-18-B_SilkS.gbr, IN-18-Edge_Cuts.gbr, IN-18-F_Cu.gbr, IN-18-F_Mask.gbr, IN-18-F_Paste.gbr]
2021-01-22 Allow git tracking to exported BOM .csv files
    [NixieController.csv, PowerSupply.csv]
